robotarium/GTernal/CAD Files/OBJ Files/Top Main Plate.obj

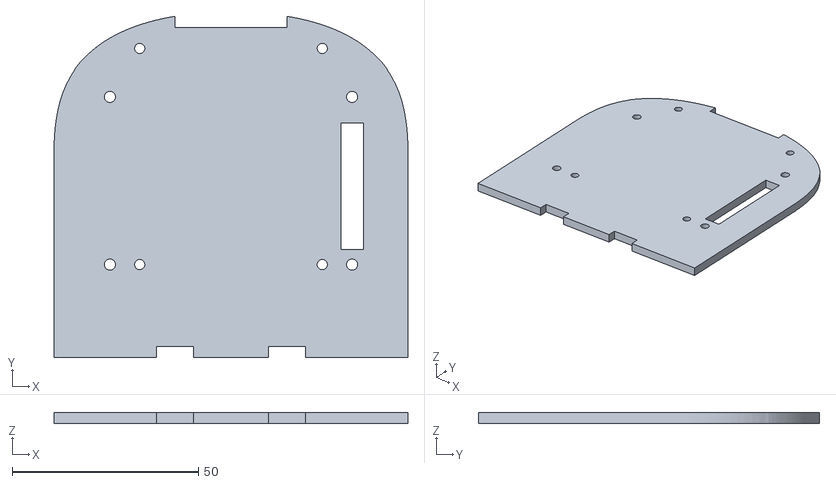
[picture p1: CAD file, 2023-09-16, last stored version]
CAD Files/OBJ Files/Top Main Plate.obj
95.0 x 91.6 x 3.00
