robotarium/GTernal/CAD Files/OBJ Files/Camera Mount V3.obj

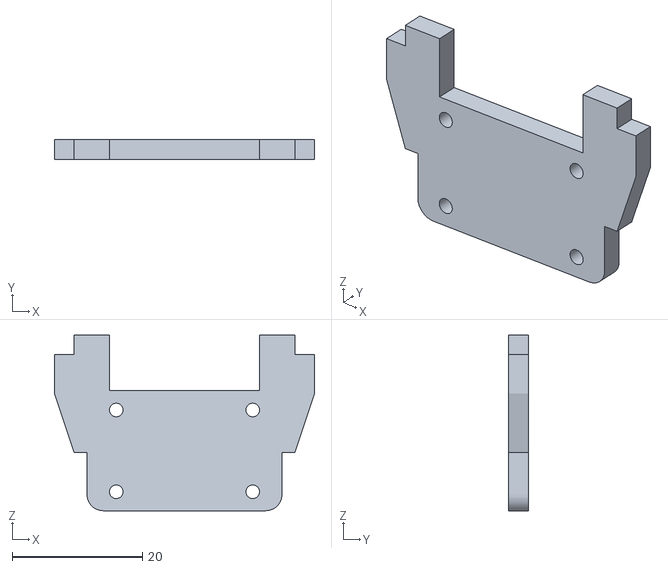
[picture p2: CAD file, 2023-09-16, last stored version]
CAD Files/OBJ Files/Camera Mount V3.obj
40.0 x 3.00 x 27.0
