robotarium/GTernal/CAD Files/OBJ Files/Top Plate V2.obj

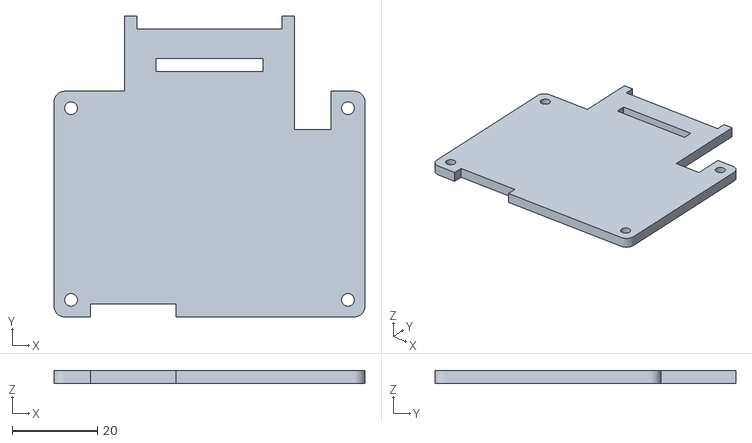
[picture p3: CAD file, 2023-09-16, last stored version]
CAD Files/OBJ Files/Top Plate V2.obj
73.0 x 70.6 x 3.00
