robotarium/GTernal/CAD Files/OBJ Files/Distance Sensor mount sub part 1 V1.obj

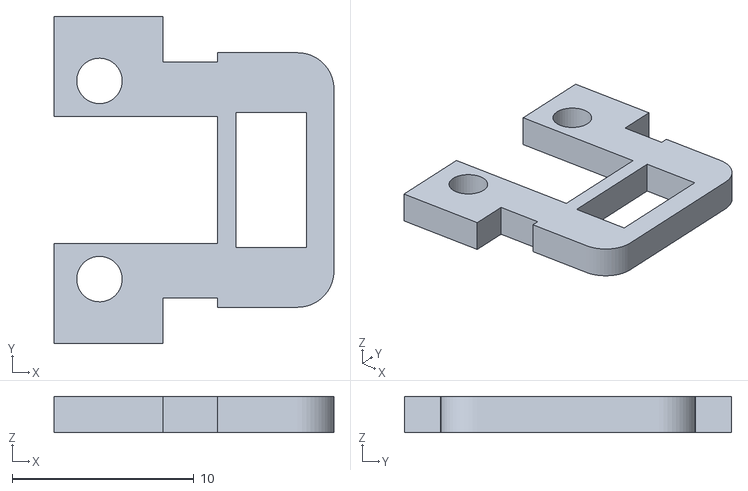
[picture p4: CAD file, 2023-09-16, last stored version]
CAD Files/OBJ Files/Distance Sensor mount sub part 1 V1.obj
15.4 x 18.0 x 2.00
