robotarium/GTernal/CAD Files/OBJ Files/Distance Sensor Mount Subtractive Part 2 V5.obj

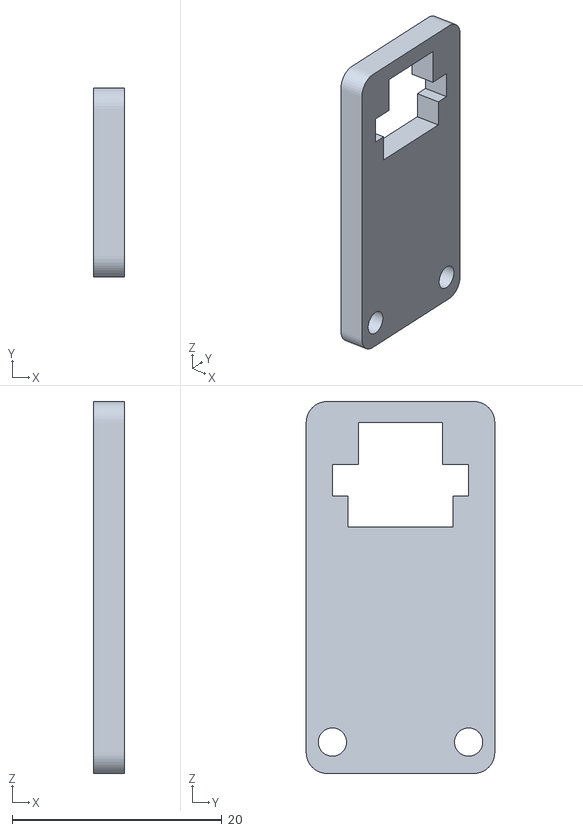
[picture p5: CAD file, 2023-09-16, last stored version]
CAD Files/OBJ Files/Distance Sensor Mount Subtractive Part 2 V5.obj
3.00 x 18.0 x 35.5
