robotarium/GTernal/CAD Files/OBJ Files/Bottom Panel.obj

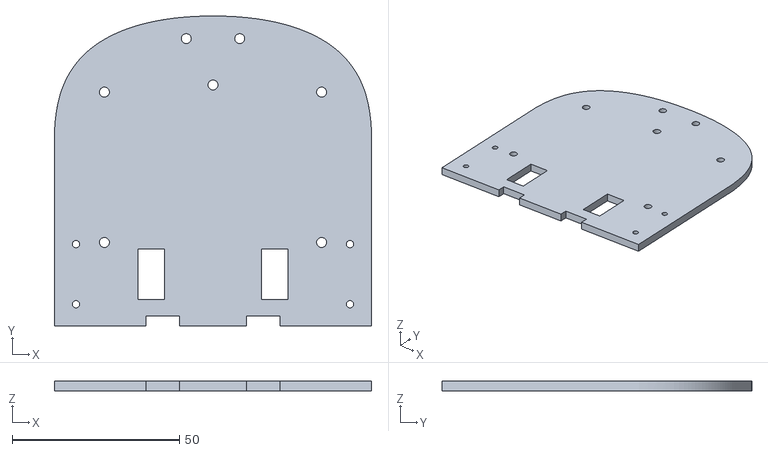
[picture p6: CAD file, 2023-09-16, last stored version]
CAD Files/OBJ Files/Bottom Panel.obj
95.0 x 92.8 x 3.00
