robotarium/GTernal/CAD Files/OBJ Files/Battery Plate.obj

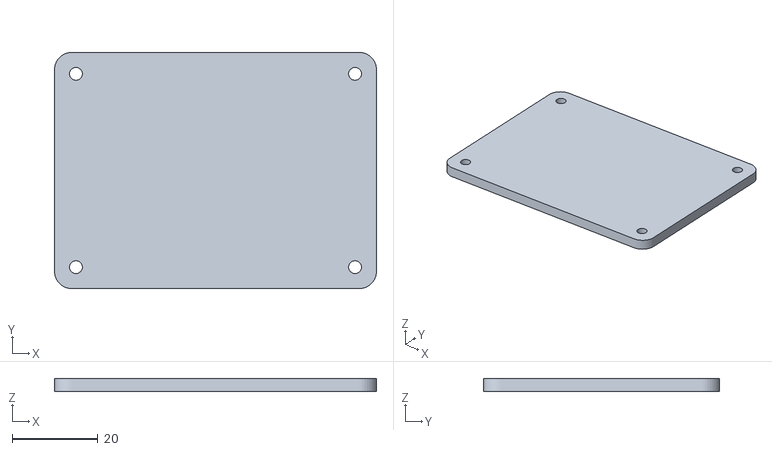
[picture p7: CAD file, 2023-09-16, last stored version]
CAD Files/OBJ Files/Battery Plate.obj
75.0 x 55.0 x 3.00
