robotarium/GTernal/CAD Files/OBJ Files/Back Panel 3mm.obj

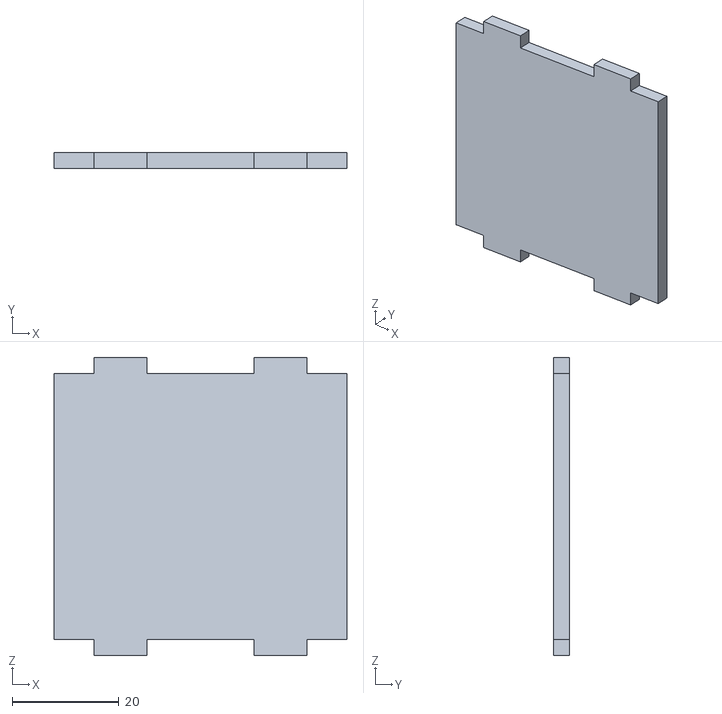
[picture p8: CAD file, 2023-09-16, last stored version]
CAD Files/OBJ Files/Back Panel 3mm.obj
55.0 x 3.00 x 56.0
