robotarium/GTernal/(list of files, cad)

Other CAD files:
CAD Files/Components/EDAC_1743_RJ45_TH.f3d
CAD Files/Components/Pin+Header+2x2+TH+Pitch+2.f3d
CAD Files/Components/SMD+PTC+Fuse+MF-MSMF250_16X.f3d
CAD Files/Components/SOP-3+2.f3d
CAD Files/Components/SOP-3.f3d
CAD Files/Components/TSOP-2+4mm.f3d
CAD Files/Components/TSOP-6+2mm.f3d
CAD Files/Components/TSOP-6+3mm (1).f3d
CAD Files/Components/TSOP-6+3mm.f3d
CAD Files/Components/bcm2837.f3d
CAD Files/Components/cap0402.f3d
CAD Files/Components/cap0603_03.f3d
CAD Files/Components/cap1206.f3d
CAD Files/Components/capar2_1013.f3d
CAD Files/Components/crystal_dfn4.f3d
CAD Files/Components/ind2520.f3d
CAD Files/Components/ledra_0603.f3d
CAD Files/Components/molex+hdmi+smt.f3d
CAD Files/Components/pj-322.f3d
CAD Files/Components/qfn48_9mm.f3d
CAD Files/Components/qfn80_12mm.f3d
CAD Files/Components/qfp16_3x2mm.f3d
CAD Files/Components/resistor_0402.f3d
CAD Files/Components/wlbga140_5mm.f3d
CAD Files/GTernal v29.f3z
CAD Files/GTernal_3.f3z
CAD Files/GTernal_No_PCB v10.f3z
CAD Files/GTernal_No_PCB.f3z
CAD Files/Gritsbot_3.f3z
CAD Files/Gritsbot_No_PCB v10.f3z
CAD Files/Gritsbot_No_PCB.f3z
CAD Files/PCB_Drawing.f3z
CAD Files/PCB_DrawingV2.f3z
CAD Files/RPi_Camera_V2.f3d
CAD Files/ToF Cable Holder Top Mount Subtractive v7.f3z
CAD Files/ToF+Cable+Holder+Top+Mount+Subtractive.f3z
CAD Files/ToF+Cable+Holder+Top+Mount.f3z
CAD Files/VL53L0X+ToF+Sensor.f3d
CAD Files/raspberry_pi_3_b_plus.f3z
PCB Files/mainBoard_GTernal_1-0 v17.f3z
PCB Files/mainBoard_Gritsbot_3-0.f3z
