robotarium/GTernal/PCB Files/mainBoard_Gritsbot_3-0.brd

## EAGLE design PCB Files/mainBoard_Gritsbot_3-0.brd (2023-09-16, last stored version)

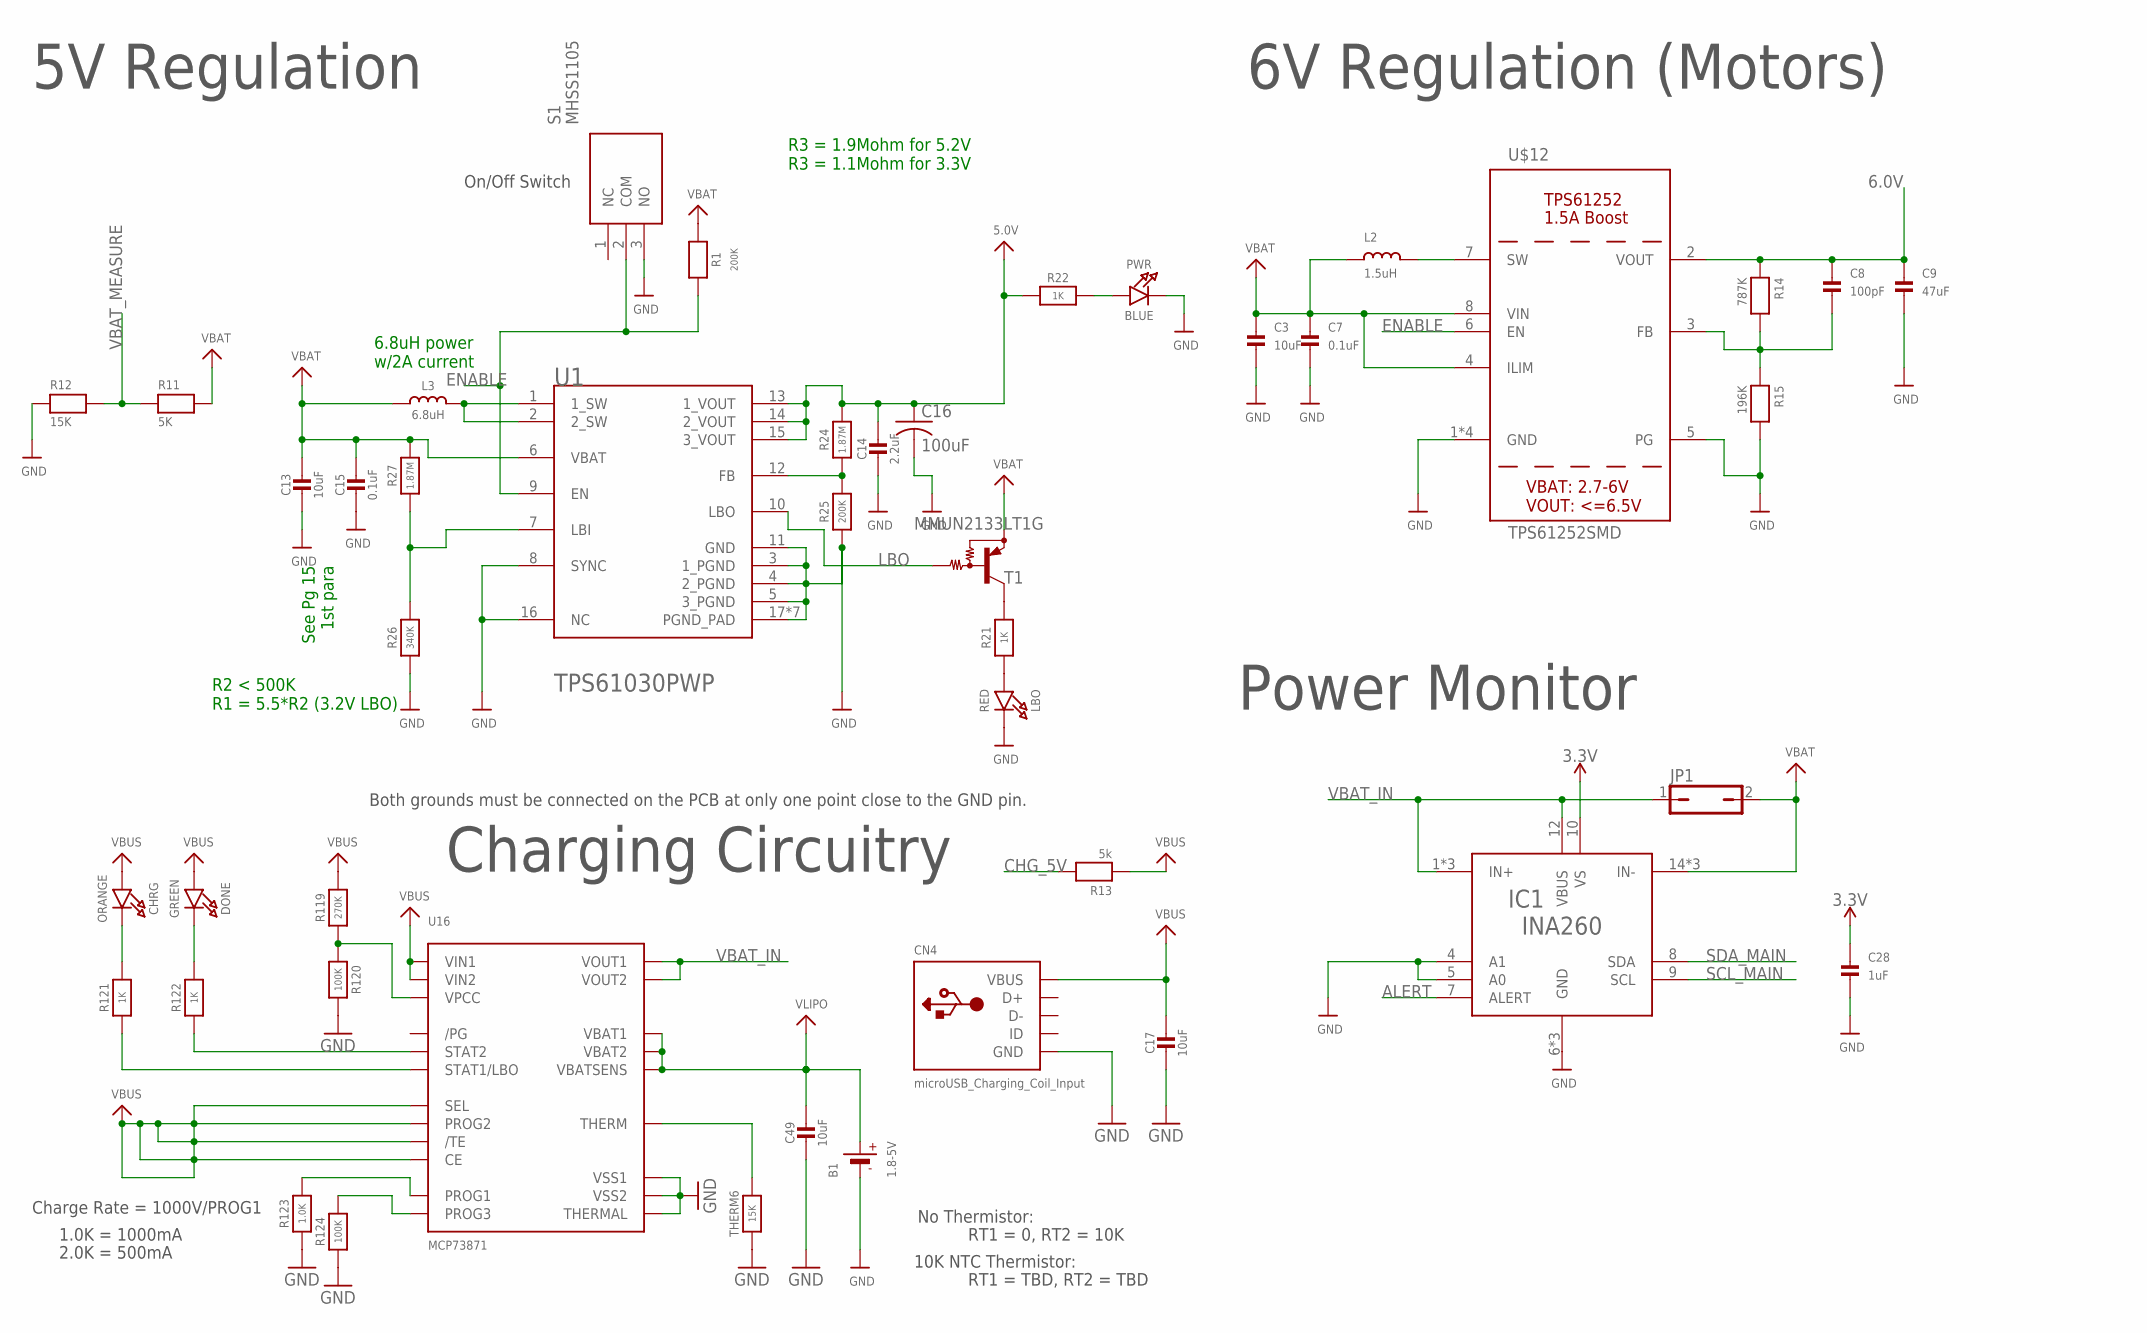
[picture p9: schematic mainBoard_Gritsbot_3-0.sch, sheet 1]

Parts:
B1: 1.8-5V; JSTPH2
C3: 10uF; 0603
C7: 0.1uF; 0805
C8: 100pF; 0603
C9: 47uF; 1206
C13, C17, C49: 10uF; 0805-NO
C14: 2.2uF; 0805-NO
C15: 0.1uF; 0805_10MGAP
C16: 100uF; C1210
C28: 1uF; 0603-NO
CHRG: ORANGE; CHIPLED_0805_NOOUTLINE
CN4: microUSB_Charging_Coil_Input; 4UCONN_20329
DONE: GREEN; CHIPLED_0805_NOOUTLINE
IC1: INA260; TSSOP16
JP1: JP1Q; JP1
L2: 1.5uH; MURATA_DFE252012P-1R5M=P2
L3: 6.8uH; INDUCTOR_5X5MM_TDK_VLC5045
LBO: RED; CHIPLED_0805_NOOUTLINE
PWR: BLUE; CHIPLED_0805_NOOUTLINE
R1, R25: 200K; 0805-NO
R11: 5K; 0805
R12: 15K; 0805
R13: 5k; 0805
R14: 787K; 0805
R15: 196K; 0805
R21, R22, R121, R122: 1K; 0805-NO
R24: 1.87M; 0805-NO
R26: 340K; _0805MP
R27: 1.87M; _0805MP
R119: 270K; 0805-NO
R120, R124: 100K; 0805-NO
R123: 1.0K; 0805-NO
S1: MHSS1105
T1: MMUN2133LT1G; SC59-BEC
THERM6: 15K; 0805-NO
U1: TEXAS_INSTRUMENTS_TPS61030PWPTEXAS_INSTRUMENTS_TP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; TEXAS_INSTRUMENTS_TPS61030PWP_0
U16: MCP73871; QFN20_4MM
U$12: TPS61252SMD; TPS61252

Connections:
3.3V: C28.1, IC1.10 (VS); also elsewhere on the board
5.0V: C14.1, C16.1, R22.1, R24.2, U1.13 (1_VOUT), U1.14 (2_VOUT), U1.15 (3_VOUT); also elsewhere on the board
6.0V: C8.1, C9.1, R14.1, U$12.2 (VOUT); also elsewhere on the board
ALERT: IC1.7 (ALERT)
CHG_5V: R13.2; also elsewhere on the board
ENABLE: R1.2, S1.2 (COM), U1.9 (EN), U$12.6 (EN)
GND: B1.1 (-), C3.2, C7.2, C9.2, C13.2, C14.2, C15.2, C16.2, C17.2, C28.2, C49.2, CN4.BASE@1 (GND), CN4.BASE@2 (GND), CN4.GND, CN4.SPRT@1 (GND), CN4.SPRT@2 (GND), CN4.SPRT@3 (GND), CN4.SPRT@4 (GND), IC1.4 (A1), IC1.5 (A0), IC1.6 (GND), IC1.11 (GND), IC1.13 (GND), LBO.C, PWR.C, R12.1, R15.2, R25.1, R26.1, R120.2, R123.1, R124.1, S1.3 (NO), THERM6.1, U1.3 (1_PGND), U1.4 (2_PGND), U1.5 (3_PGND), U1.8 (SYNC), U1.11 (GND), U1.16 (NC), U1.17 (PGND_PAD), U1.PAD_1 (PGND_PAD), U1.PAD_2 (PGND_PAD), U1.PAD_3 (PGND_PAD), U1.PAD_4 (PGND_PAD), U1.PAD_5 (PGND_PAD), U1.PAD_6 (PGND_PAD), U16.P$10 (VSS1), U16.P$11 (VSS2), U16.P$21 (THERMAL), U$12.1 (GND), U$12.5 (PG), U$12.P$2_GND (GND), U$12.P$3_GND (GND), U$12.THERMAL_GND (GND); also elsewhere on the board
LBO: T1.B, U1.10 (LBO)
unnamed: R24.1, R25.2, U1.12 (FB)
unnamed: L2.P$2 (2), U$12.7 (SW)
unnamed: C8.2, R14.2, R15.1, U$12.3 (FB)
unnamed: L3.P$2 (2), U1.1 (1_SW), U1.2 (2_SW)
unnamed: R26.2, R27.1, U1.7 (LBI)
unnamed: LBO.A, R21.1
unnamed: R21.2, T1.C
unnamed: PWR.A, R22.2
unnamed: R119.1, R120.1, U16.P$2 (VPCC)
unnamed: R122.1, U16.P$7 (STAT2)
unnamed: R121.1, U16.P$8 (STAT1/LBO)
unnamed: R123.2, U16.P$13 (PROG1)
unnamed: THERM6.2, U16.P$5 (THERM)
unnamed: DONE.C, R122.2
unnamed: CHRG.C, R121.2
unnamed: R124.2, U16.P$12 (PROG3)
SCL_MAIN: IC1.9 (SCL); also elsewhere on the board
SDA_MAIN: IC1.8 (SDA); also elsewhere on the board
VBAT: C3.1, C7.1, C13.1, C15.1, IC1.14 (IN-), IC1.15 (IN-), IC1.16 (IN-), JP1.2, L2.P$1 (1), L3.P$1 (1), R1.1, R11.2, R27.2, T1.E, U1.6 (VBAT), U$12.4 (ILIM), U$12.8 (VIN)
VBAT_IN: IC1.1 (IN+), IC1.2 (IN+), IC1.3 (IN+), IC1.12 (VBUS), JP1.1, U16.P$1 (VOUT1), U16.P$20 (VOUT2)
VBAT_MEASURE: R11.1, R12.2; also elsewhere on the board
VBUS: C17.1, CHRG.A, CN4.VBUS, DONE.A, R13.1, R119.2, U16.P$3 (SEL), U16.P$4 (PROG2), U16.P$9 (/TE), U16.P$17 (CE), U16.P$18 (VIN1), U16.P$19 (VIN2)
VLIPO: B1.2 (+), C49.1, U16.P$14 (VBAT1), U16.P$15 (VBAT2), U16.P$16 (VBATSENS)

Notes on the sheet:
R2 < 500K R1 = 5.5*R2 (3.2V LBO)
Charging Circuitry
5V Regulation
6V Regulation (Motors)
Charge Rate = 1000V/PROG1
1.0K = 1000mA
2.0K = 500mA
No Thermistor:
10K NTC Thermistor:
RT1 = 0, RT2 = 10K
RT1 = TBD, RT2 = TBD
Both grounds must be connected on the PCB at only one point close to the GND pin.
On/Off Switch
See Pg 15 1st para
6.8uH power w/2A current
R3 = 1.9Mohm for 5.2V R3 = 1.1Mohm for 3.3V
Power Monitor

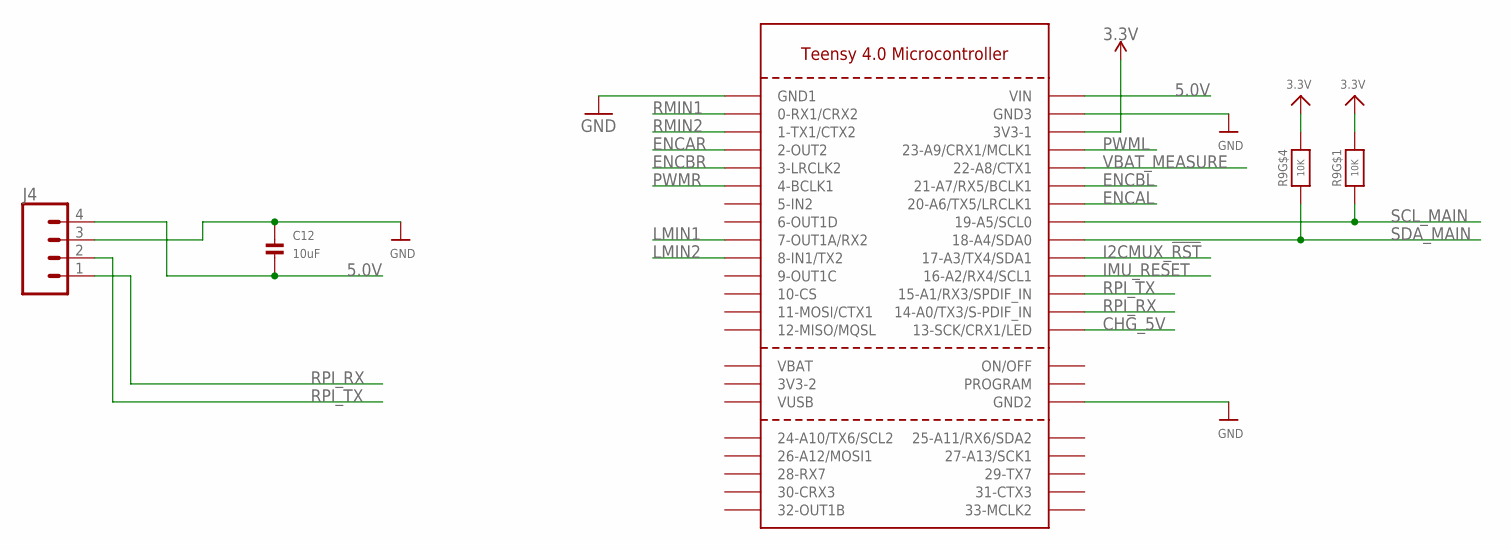
[picture p10: schematic mainBoard_Gritsbot_3-0.sch, sheet 2]

Parts:
C12: 10uF; 0603
J4: CONN_041X04_NO_SILK; 1X04_NO_SILK
R9: 10K; RESPACK_4X0603
U$57: TEENSY40

Connections:
3.3V: R9.1, R9.4 (1), U$57.3V3-1; also elsewhere on the board
5.0V: C12.2, J4.4, U$57.VIN; also elsewhere on the board
CHG_5V: U$57.13-SCK/CRX1/LED; also elsewhere on the board
ENCAL: U$57.20-A6/TX5/LRCLK1; also elsewhere on the board
ENCAR: U$57.2-OUT2; also elsewhere on the board
ENCBL: U$57.21-A7/RX5/BCLK1; also elsewhere on the board
ENCBR: U$57.3-LRCLK2; also elsewhere on the board
GND: C12.1, J4.3, U$57.GND1, U$57.GND2, U$57.GND3; also elsewhere on the board
I2CMUX_!RST: U$57.17-A3/TX4/SDA1; also elsewhere on the board
IMU_RESET: U$57.16-A2/RX4/SCL1; also elsewhere on the board
LMIN1: U$57.7-RX2/OUT1A (7-OUT1A/RX2); also elsewhere on the board
LMIN2: U$57.8-TX2/IN1 (8-IN1/TX2); also elsewhere on the board
PWML: U$57.23-A9/CRX1/CCLK1 (23-A9/CRX1/MCLK1); also elsewhere on the board
PWMR: U$57.4-BCLK2 (4-BCLK1); also elsewhere on the board
RMIN1: U$57.0-RX1 (0-RX1/CRX2); also elsewhere on the board
RMIN2: U$57.1-TX1 (1-TX1/CTX2); also elsewhere on the board
RPI_RX: J4.1, U$57.14-A0/TX3/S-PFI_OUT (14-A0/TX3/S-PDIF_IN)
RPI_TX: J4.2, U$57.15-A1/RX3/S-PDIF_IN (15-A1/RX3/SPDIF_IN)
SCL_MAIN: R9.8 (2), U$57.19-A5/SCL0; also elsewhere on the board
SDA_MAIN: R9.5 (2), U$57.18-A4/SDA0; also elsewhere on the board
VBAT_MEASURE: U$57.22-A8/CTX1; also elsewhere on the board

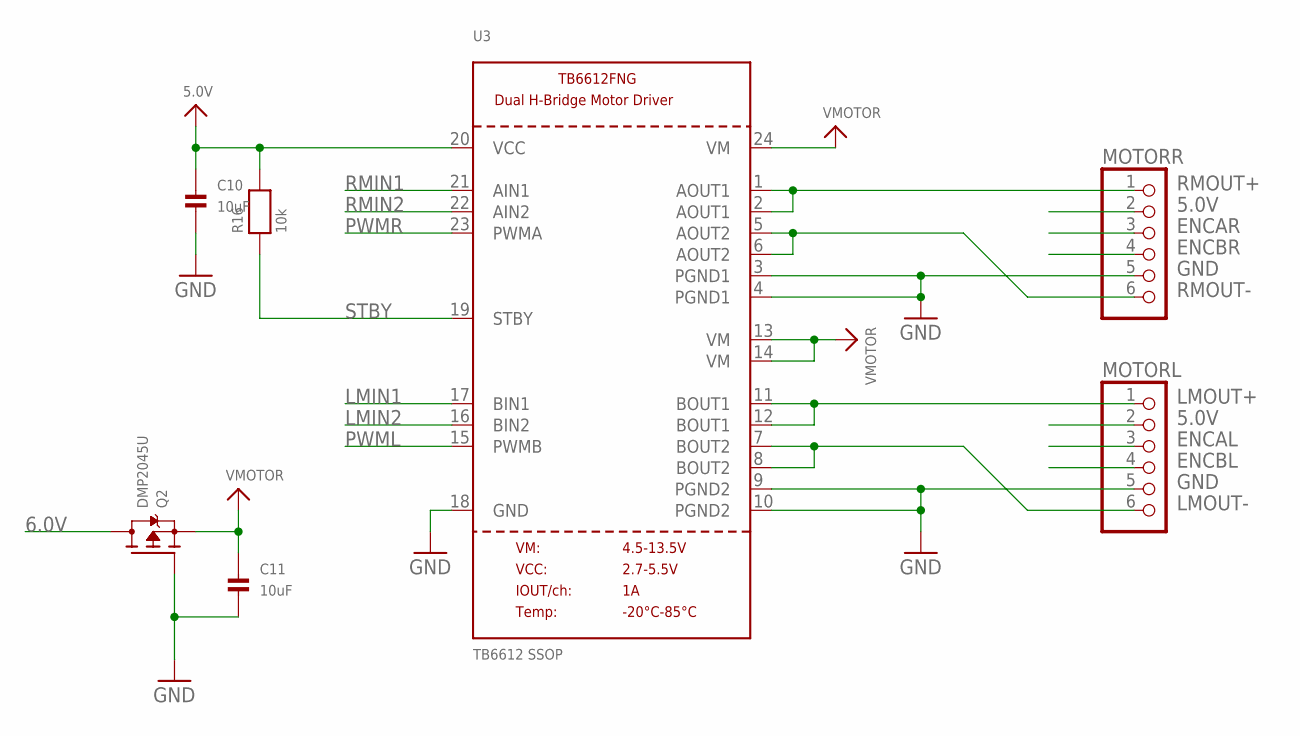
[picture p11: schematic mainBoard_Gritsbot_3-0.sch, sheet 3]

Parts:
C10, C11: 10uF; 0603
MOTORL: PINHD-1X6CB; 1X06-CLEANBIG
MOTORR: PINHD-1X6CB; 1X06-CLEANBIG
Q2: DMP2045U; SOT23-WIDE
R16: 10k; 0805
U3: TB6612 SSOP; SSOP24

Connections:
5.0V: C10.1, MOTORL.2, MOTORR.2, R16.2, U3.20 (VCC); also elsewhere on the board
6.0V: Q2.3 (D); also elsewhere on the board
ENCAL: MOTORL.3; also elsewhere on the board
ENCAR: MOTORR.3; also elsewhere on the board
ENCBL: MOTORL.4; also elsewhere on the board
ENCBR: MOTORR.4; also elsewhere on the board
GND: C10.2, C11.2, MOTORL.5, MOTORR.5, Q2.1 (G), U3.3 (PGND1), U3.4 (PGND1), U3.9 (PGND2), U3.10 (PGND2), U3.18 (GND); also elsewhere on the board
LMIN1: U3.17 (BIN1); also elsewhere on the board
LMIN2: U3.16 (BIN2); also elsewhere on the board
LMOUT+: MOTORL.1, U3.11 (BOUT1), U3.12 (BOUT1)
LMOUT-: MOTORL.6, U3.7 (BOUT2), U3.8 (BOUT2)
PWML: U3.15 (PWMB); also elsewhere on the board
PWMR: U3.23 (PWMA); also elsewhere on the board
RMIN1: U3.21 (AIN1); also elsewhere on the board
RMIN2: U3.22 (AIN2); also elsewhere on the board
RMOUT+: MOTORR.1, U3.1 (AOUT1), U3.2 (AOUT1)
RMOUT-: MOTORR.6, U3.5 (AOUT2), U3.6 (AOUT2)
STBY: R16.1, U3.19 (STBY)
VMOTOR: C11.1, Q2.2 (S), U3.13 (VM), U3.14 (VM), U3.24 (VM)

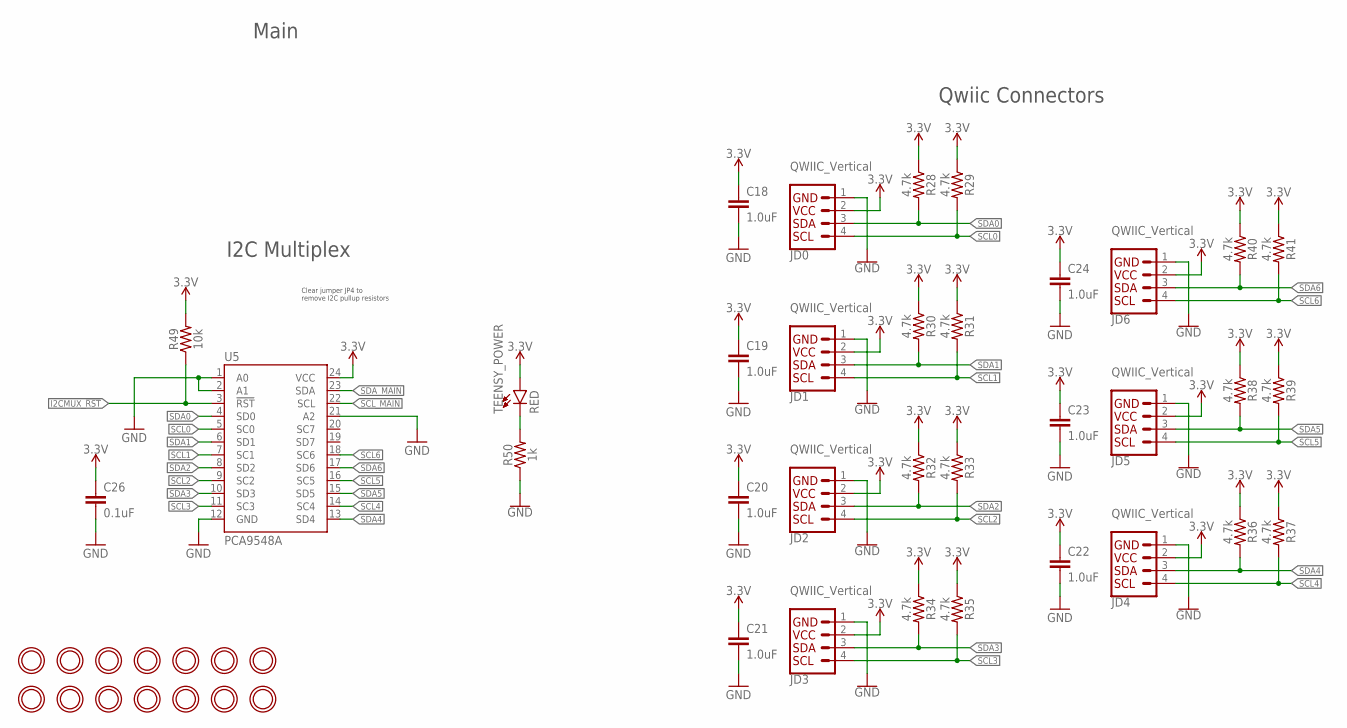
[picture p12: schematic mainBoard_Gritsbot_3-0.sch, sheet 4]

Parts:
C18, C19, C20, C21, C22, C23, C24: 1.0uF; 0603
C26: 0.1uF; 0603
JD0, JD1, JD2, JD3, JD4, JD5, JD6: QWIIC_Vertical; JST04_1MM_VERT
R28, R29, R30, R31, R32, R33, R34, R35, R36, R37, R38, R39, R40, R41: 4.7k; 0603
R49: 10k; 0603
R50: 1k; 0603
TEENSY_POWER: RED; LED-0603
U5: PCA9548A; TSSOP28
U$8, U$30, U$31, U$32, U$33, U$34, U$35, U$36, U$37, U$43, U$45, U$46, U$47, U$48: MOUNTINGHOLE2.5; MOUNTINGHOLE_2.5_PLATED

Connections:
3.3V: C18.1, C19.1, C20.1, C21.1, C22.1, C23.1, C24.1, C26.1, JD0.2, JD1.2, JD2.2, JD3.2, JD4.2, JD5.2, JD6.2, R28.1, R29.1, R30.1, R31.1, R32.1, R33.1, R34.1, R35.1, R36.1, R37.1, R38.1, R39.1, R40.1, R41.1, R49.2, TEENSY_POWER.A, U5.24 (VCC); also elsewhere on the board
GND: C18.2, C19.2, C20.2, C21.2, C22.2, C23.2, C24.2, C26.2, JD0.1, JD1.1, JD2.1, JD3.1, JD4.1, JD5.1, JD6.1, R50.1, U5.1 (A0), U5.2 (A1), U5.12 (GND), U5.21 (A2); also elsewhere on the board
I2CMUX_!RST: R49.1, U5.3 (!RST); also elsewhere on the board
unnamed: R50.2, TEENSY_POWER.C
SCL0: JD0.4, R29.2, U5.5 (SC0)
SCL1: JD1.4, R31.2, U5.7 (SC1)
SCL2: JD2.4, R33.2, U5.9 (SC2)
SCL3: JD3.4, R35.2, U5.11 (SC3)
SCL4: JD4.4, R37.2, U5.14 (SC4)
SCL5: JD5.4, R39.2, U5.16 (SC5)
SCL6: JD6.4, R41.2, U5.18 (SC6)
SCL_MAIN: U5.22 (SCL); also elsewhere on the board
SDA0: JD0.3, R28.2, U5.4 (SD0)
SDA1: JD1.3, R30.2, U5.6 (SD1)
SDA2: JD2.3, R32.2, U5.8 (SD2)
SDA3: JD3.3, R34.2, U5.10 (SD3)
SDA4: JD4.3, R36.2, U5.13 (SD4)
SDA5: JD5.3, R38.2, U5.15 (SD5)
SDA6: JD6.3, R40.2, U5.17 (SD6)
SDA_MAIN: U5.23 (SDA); also elsewhere on the board

Notes on the sheet:
Qwiic Connectors
Main
I2C Multiplex
Clear jumper JP4 to remove I2C pullup resistors

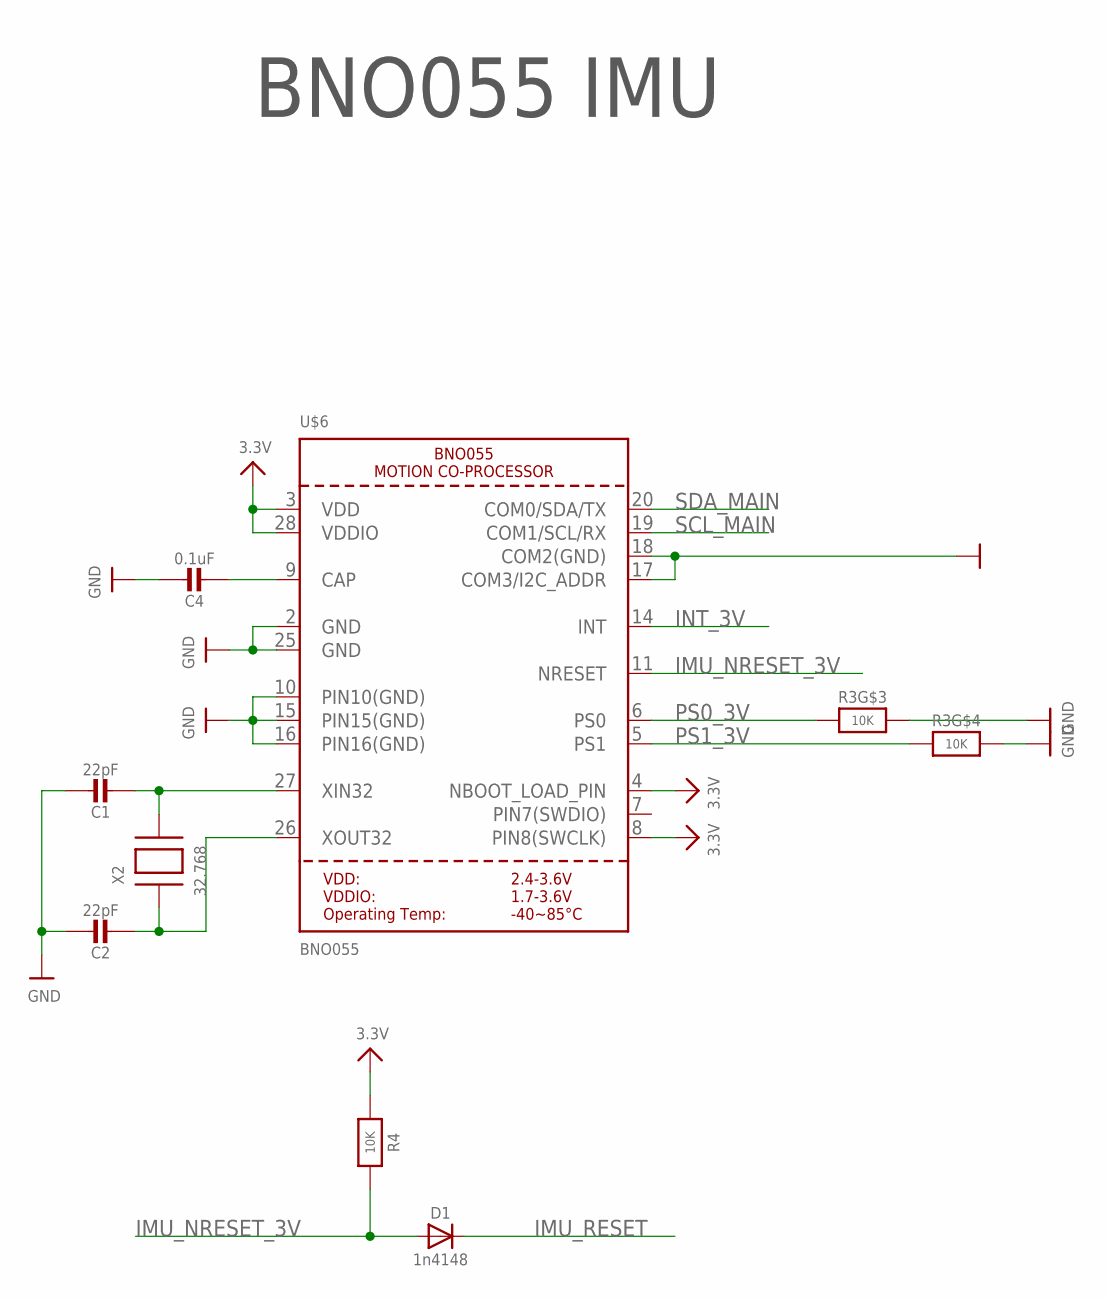
[picture p13: schematic mainBoard_Gritsbot_3-0.sch, sheet 5]

Parts:
C1, C2: 22pF; 0603-NO
C4: 0.1uF; 0603-NO
D1: 1n4148; SOD-323
R3: 10K; RESPACK_4X0603
R4: 10K; 0603-NO
U$6: BNO055
X2: 32.768; XTAL3215

Connections:
3.3V: R4.1, U$6.3 (VDD), U$6.4 (NBOOT_LOAD_PIN), U$6.8 (PIN8(SWCLK)), U$6.28 (VDDIO); also elsewhere on the board
GND: C1.1, C2.1, C4.1, R3.5 (2), R3.6 (2), U$6.2 (GND), U$6.10 (PIN10(GND)), U$6.15 (PIN15(GND)), U$6.16 (PIN16(GND)), U$6.17 (COM3/I2C_ADDR), U$6.18 (COM2(GND)), U$6.25 (GND); also elsewhere on the board
IMU_NRESET_3V: D1.A, R4.2, U$6.11 (NRESET)
IMU_RESET: D1.C; also elsewhere on the board
INT_3V: U$6.14 (INT)
unnamed: C1.2, U$6.27 (XIN32), X2.P$2
unnamed: C2.2, U$6.26 (XOUT32), X2.P$1
unnamed: C4.2, U$6.9 (CAP)
PS0_3V: R3.3 (1), U$6.6 (PS0)
PS1_3V: R3.4 (1), U$6.5 (PS1)
SCL_MAIN: U$6.19 (COM1/SCL/RX); also elsewhere on the board
SDA_MAIN: U$6.20 (COM0/SDA/TX); also elsewhere on the board

Notes on the sheet:
BNO055 IMU

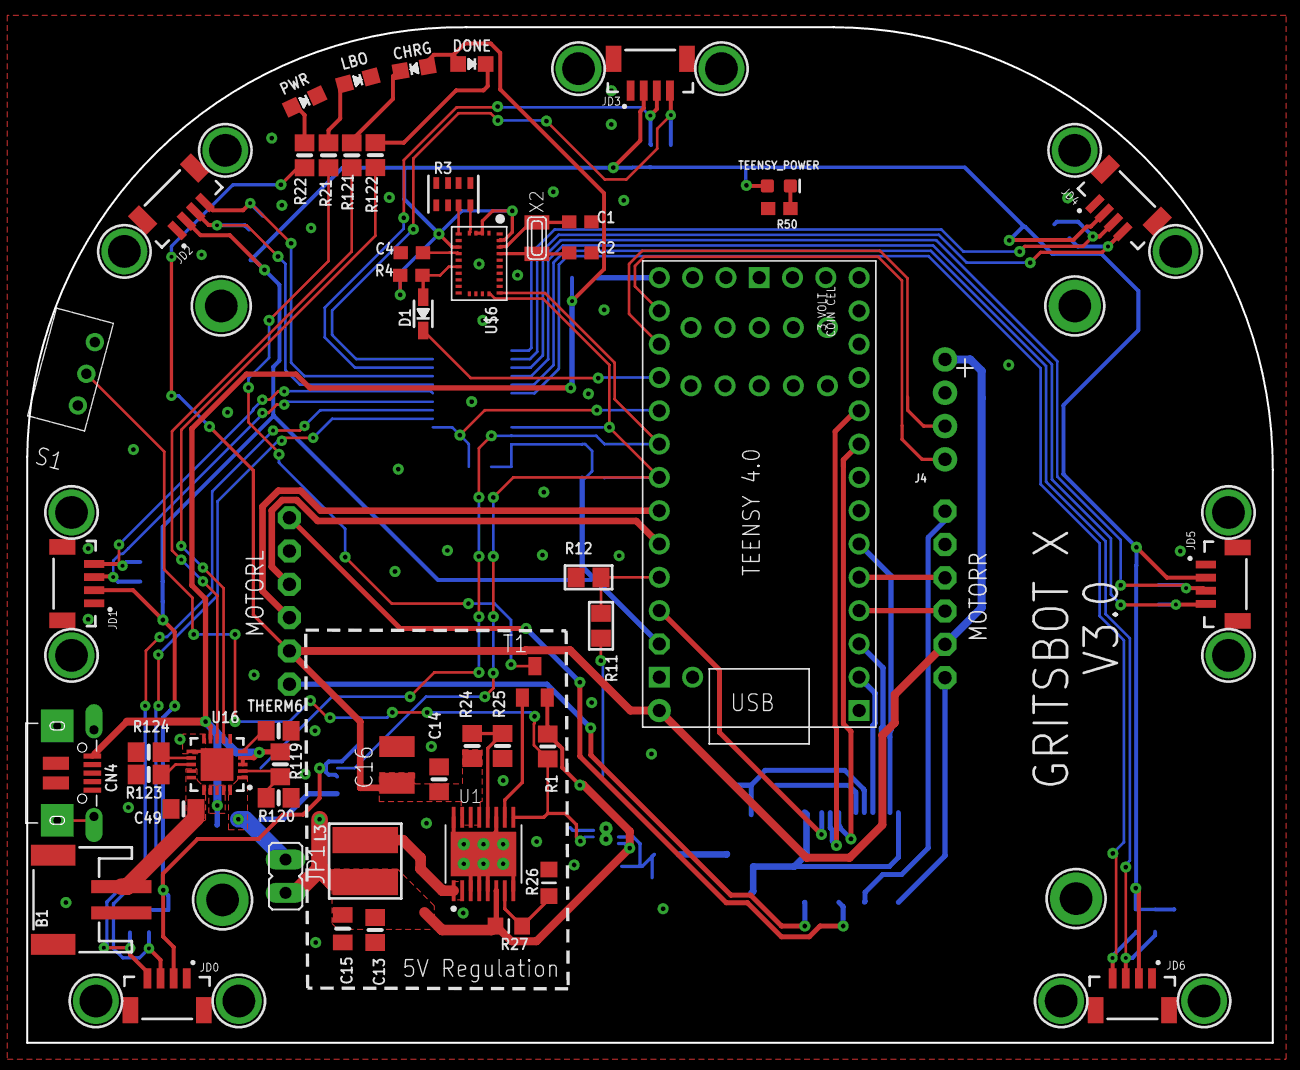
[picture p14: board mainBoard_Gritsbot_3-0.brd from above]

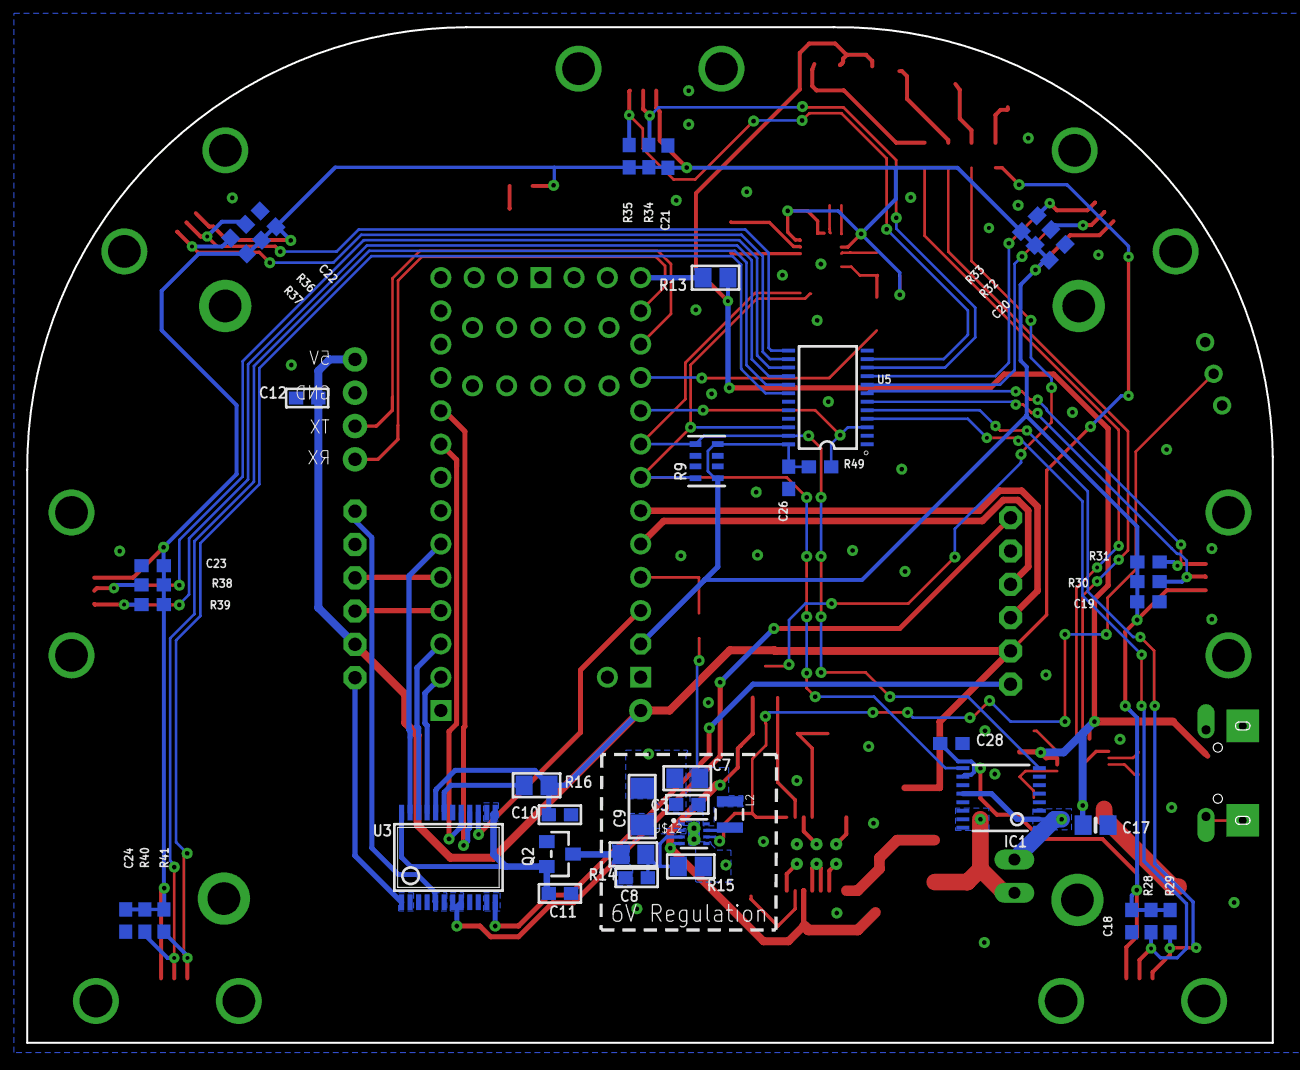
[picture p15: board mainBoard_Gritsbot_3-0.brd from below]

Board: 2 copper layers, 95.0 x 77.5 mm, 115 parts (43 on the bottom side), 71 nets.

Other parts of the board:
U$7, U$23, U$28, U$29: MOUNTINGHOLE_2.5_PLATED_THICK
