robotarium/GTernal/firmware/RPi/pi_firmware.py

import firmware.RPi.gritsbotserial as gritsbotserial
import json
import vizier.node as node
import time
import argparse
import queue
import netifaces
import vizier.log as log
import subprocess

global logger
logger = log.get_logger()

# Constants
MAX_QUEUE_SIZE = 100
LOW_BATT_THRESHOLD = 3900.0 # Low battery threshold voltage in mV
BATT_VOLT_WINDOW = 30 # Time window in seconds for the moving average of the battery voltage. Currently, it is set to 1 sample per second.

def get_mac():
    """Gets the MAC address for the robot from the network config info.
    Returns:
        str: A MAC address for the robot.
    Example:
        >>> print(get_mac())
        AA:BB:CC:DD:EE:FF
    """

    interface = [x for x in netifaces.interfaces() if 'wlan' in x][0]
    return netifaces.ifaddresses(interface)[netifaces.AF_LINK][0]['addr']


def create_node_descriptor(end_point):
    """Returns a node descriptor for the robot based on the end_point.
    The server_alive link is for the robot to check the MQTT connection periodically.
    Args:
        end_point (str): The ID of the robot.
    Returns:
        dict: A node descriptor of the vizier format for the robot.
    Example:
        >>> node_descriptor(1)
    """
    node_descriptor = \
        {
            'end_point': end_point,
            'links':
            {
                '/status': {'type': 'DATA'},
            },
            'requests':
            [
                {
                    'link': 'matlab_api/'+end_point,
                    'type': 'STREAM',
                    'required': False
                },
            ]
        }

    return node_descriptor

# Responses
# Battery voltage response
# response = {'status': 1, 'body': {'bat_volt': 4.3}}


class Request:
    """Represents serial requests to the microcontroller.
    The serial communications operate on a request/response architecture.  For example, the request is of a form (when JSON encoded)
    .. code-block:: python
        {'request': ['read', 'write', 'read'], 'iface': [iface1, iface2, iface3], body: [body1, body2, body3]}
    Attributes:
        request (list): A list of requests (or actions) to perform.  Must be 'read' or 'write'.
        iface (list): A list of interfaces on which to perform the request
        body (list): A list of bodies for the requests.  These are empty if the request is a read.
    """

    def __init__(self):
        """Initializes a request with optional iface, request, and body parameters.
        Returns:
            The created request.
        """
        self.iface = []
        self.request = []
        self.body = []

    def add_write_request(self, iface, body):
        """Adds a write to the request.
        Args:
            iface (str): The interface to write.
            body (dict): A JSON-encodable body to be written.
        Returns:
            The modified request containing the new interface and body.
        Examples:
            >>> r = Request().add_write_request('motor', {'v': 0.1, 'w': 0.0})
        """

        self.iface.append(iface)
        self.request.append('write')
        self.body.append(body)

        return self

    def add_read_request(self, iface):
        """Adds a read to the request.
        Args:
            iface (str): Interface from which to read.
        Returns:
            The request with the added read.
        """

        self.iface.append(iface)
        self.request.append('read')
        self.body.append({})

        return self

    def to_json_encodable(self):
        """Turns the request into a JSON-encodable dict.
        Raises:
            Exception: If an underlying body element is not JSON-encodable.
        Returns:
            dict: A JSON-encodable dict representing the request.
        """

        req = {'request': self.request, 'iface': self.iface}

        if(self.body):
            req['body'] = self.body

        return req


def handle_write_response(status, body):
    return {}


def handle_read_response(iface, status, body):

    if(iface in body):
        return {iface: body[iface]}
    else:
        logger.critical('Request for ({0}) not in body ({1}) after request.'.format(iface, body))
        return {}

def avgVoltage(battVoltArray, voltNew, battVoltIndx, chargeStatusArray, statusNew):
    battVoltArray[battVoltIndx] = voltNew
    avgVolt = sum(battVoltArray)/len(battVoltArray)
    chargeStatusArray[battVoltIndx] = statusNew

    battVoltIndx = battVoltIndx + 1
    if battVoltIndx >= BATT_VOLT_WINDOW:
        battVoltIndx = 0

    return avgVolt, battVoltIndx


def main():

    parser = argparse.ArgumentParser()
    parser.add_argument("mac_list", help="JSON file containing MAC to id mapping")
    parser.add_argument("-port", type=int, help="MQTT Port", default=8080)
    parser.add_argument("-host", help="MQTT Host IP", default="localhost")
    parser.add_argument('-update_rate', type=float, help='Update rate for robot main loop', default=0.016)
    parser.add_argument('-status_update_rate', type=float, help='How often to check status info', default=1)

    # Retrieve the MAC address for the robot
    mac_address = get_mac()

    # Parser and set CLI arguments
    args = parser.parse_args()
    update_rate = args.update_rate
    status_update_rate = args.status_update_rate

    # Retrieve the MAC list file, containing a mapping from MAC address to robot ID
    try:
        f = open(args.mac_list, 'r')
        mac_list = json.load(f)
    except Exception as e:
        print(repr(e))
        print('Could not open file ({})'.format(args.node_descriptor))

    if(mac_address in mac_list):
        robot_id = mac_list[mac_address]
    else:
        print('MAC address {} not in supplied MAC list file'.format(mac_address))
        raise ValueError()

    logger.info('This is robot: ({0}) with MAC address: ({1})'.format(robot_id, mac_address))

    # Create node descriptor for robot and set up links
    node_descriptor = create_node_descriptor(mac_list[mac_address])
    status_link = robot_id + '/status'
    input_link = 'matlab_api/' + robot_id

    started = False
    robot_node = None
    while (not started):
        robot_node = node.Node(args.host, args.port, node_descriptor)
        try:
            robot_node.start()
            started = True
        except Exception as e:
            logger.critical('Could not start robot node.')
            logger.critical(repr(e))
            robot_node.stop()

        # Don't try to make nodes too quickly
        time.sleep(1)

    logger.info('Started robot node.')

    started = False
    serial = None
    while (not started):
        serial = gritsbotserial.GritsbotSerial(serial_dev='/dev/ttyAMA0', baud_rate=500000)
        try:
            serial.start()
            started = True
        except Exception as e:
            # This class stops itself if the device cannot be initially acquired, so we don't need to stop it.
            logger.critical('Could not acquire serial device.')
            logger.critical(repr(e))

        # Don't try to acquire the serial device too quickly
        time.sleep(1)

    logger.info('Acquired serial device.')

    # Queues for STREAM links
    inputs = robot_node.subscribe(input_link)

    # Initialize times for various activities
    start_time = time.time()
    print_time = time.time()
    status_update_time = time.time()

    # Fast charging
    battVoltArray = [0]*BATT_VOLT_WINDOW
    battVoltIndx = 0
    battThreshold = LOW_BATT_THRESHOLD
    chargeStatusArray = [0]*BATT_VOLT_WINDOW

    # Initialize data
    status_data = {'batt_volt': -1, 'charge_status': False, 'bus_volt':-1, 'bus_current':-1, 'power':-1}
    last_input_msg = {}

    # Main loop for the robot
    serial._serial.reset_input_buffer()
    serial._serial.reset_output_buffer()
    while True:
        start_time = time.time()

        # Serial requests
        request = Request()
        handlers = []

        # Retrieve status data: battery voltage and charging status
        if((start_time - status_update_time) >= status_update_rate):
            request.add_read_request('batt_volt').add_read_request('charge_status')
            request.add_read_request('bus_volt').add_read_request('bus_current').add_read_request('power')
            handlers.append(lambda status, body: handle_read_response('batt_volt', status, body))
            handlers.append(lambda status, body: handle_read_response('charge_status', status, body))
            handlers.append(lambda status, body: handle_read_response('bus_volt', status, body))
            handlers.append(lambda status, body: handle_read_response('bus_current', status, body))
            handlers.append(lambda status, body: handle_read_response('power', status, body))

            if status_data['bus_volt'] > 0:
                avgVolt, battVoltIndx = avgVoltage(battVoltArray, status_data['bus_volt'], battVoltIndx, chargeStatusArray, status_data['charge_status'])
                logger.info('avgVolt = ({})'.format(avgVolt))

            status_update_time = start_time

        # Process input commands
        input_msg = None
        # Make sure that the queue has few enough messages
        if(inputs.qsize() > MAX_QUEUE_SIZE):
            logger.critical('Queue of motor messages is too large.')

        try:
            # Clear out the queue
            while True:
                input_msg = inputs.get_nowait()
        except queue.Empty:
            pass

        if(input_msg is not None):
            try:
                input_msg = json.loads(input_msg.decode(encoding='UTF-8'))
            except Exception as e:
                logger.warning('Got malformed JSON motor message ({})'.format(input_msg))
                logger.warning(e)
                # Set this to None for the next checks
                input_msg = None

        # If we got a valid JSON input msg, look for appropriate commands
        if(input_msg is not None):
            last_input_msg = input_msg
            if('v' in input_msg and 'w' in input_msg):
                # Handle response?
                request.add_write_request('motor', {'v': input_msg['v'], 'w': input_msg['w']})
                handlers.append(handle_write_response)

            if('left_led' in input_msg):
                request.add_write_request('left_led', {'rgb': input_msg['left_led']})
                handlers.append(handle_write_response)

            if('right_led' in input_msg):
                request.add_write_request('right_led', {'rgb': input_msg['right_led']})
                handlers.append(handle_write_response)

        # Write to serial port
        response = None
        if(len(handlers) > 0 and serial._serial.is_open):
            try:
                response = serial.serial_request(request.to_json_encodable())
            except Exception as e:
                logger.critical('Serial exception.')
                logger.critical(e)

        # Call handlers
        # We'll have a status and body for each request
        if(response is not None and 'status' in response and 'body' in response
           and len(response['status']) == len(handlers) and len(response['body']) == len(handlers)):
            status = response['status']
            body = response['body']
            # Ensure the appropriate handler gets each response
            for i, handler in enumerate(handlers):
                status_data.update(handler(status[i], body[i]))
            logger.info('Status data ({})'.format(status_data))
            logger.info('Response ({})'.format(response))
            # logger.info('Battery Voltage ({})'.format(status_data['bus_volt']))
            # logger.info('Length of handlers ({})'.format(len(handlers))) # For debugging
        else:
            # If we should have responses, but we don't
            if(len(handlers) > 0):
                logger.critical('Malformed response ({})'.format(response))
                logger.info('Length of handlers ({})'.format(len(handlers)))

        robot_node.put(status_link, json.dumps(status_data))

        # If the average battery voltage is below the threshold, and the robot is being charged, enter fast charging mode
        if not 0 in battVoltArray and avgVolt < battThreshold and not 0 in chargeStatusArray:
            logger.info('Charging battery voltage for 30 seconds: ({0}) mV < ({1}) mV. Entering fast charging mode'.format(round(avgVolt, 2), battThreshold))

            # Signal Teensy that Raspberry Pi is entering fast charging mode
            request = Request()
            request.add_write_request('fast_charge', {})
            handlers.append(handle_write_response)
            response = None
            if(len(handlers) > 0 and serial._serial.is_open):
                try:
                    response = serial.serial_request(request.to_json_encodable())
                except Exception as e:
                    logger.critical('Serial exception.')
                    logger.critical(e)

            # Shut down the Raspberry Pi through ssh from the firmware Docker image
            cmd = ['sshpass', '-p', 'raspberry', 'ssh', '-o', 'UserKnownHostsFile=/dev/null', '-o', 'StrictHostKeyChecking=no', 'pi@localhost', 'sudo shutdown now']
            pid = subprocess.Popen(cmd, stdout=subprocess.PIPE)
            pid.communicate()

        # # Print out status data
        # if((start_time - print_time) >= status_update_rate):
        #     logger.info('Status data ({})'.format(status_data))
        #     logger.info('Last input message received ({})'.format(last_input_msg))
        #     print_time = time.time()

        # Sleep for whatever time is left at the end of the loop
        time.sleep(max(0, update_rate - (time.time() - start_time)))


if __name__ == '__main__':
    main()
