robotarium/GTernal/(commit log)

2023-09-16 Initial uploads
    [BOM Gritsbot 3.0.xlsx, Back Panel 3mm.obj, Battery Plate.obj, Bottom Panel.obj, Camera Mount V3.obj, Distance Sensor Mount Subtractive Part 2 V5.obj, Distance Sensor mount sub part 1 V1.obj, EDAC_1743_RJ45_TH.f3d]
2023-09-24 Code clean-ups
    [GTernal_3.f3z, GTernal_No_PCB v10.f3z, GTernal_No_PCB.f3z]
2023-09-28 Moved design files to a separate repository. The GTernal_design_diles is a submodule of this repository.
    [Back Panel 3mm.obj, Battery Plate.obj, Bottom Panel.obj, Camera Mount V3.obj, Distance Sensor Mount Subtractive Part 2 V5.obj, Distance Sensor mount sub part 1 V1.obj, EDAC_1743_RJ45_TH.f3d, GTernal v29.f3z]
2023-10-18 Updated README.md with Raspberry Pi OS version compatibility message
2023-10-18 Updated readme with Raspberry Pi OS version compatibility message
2024-04-30 Added local installation scripts and fast charging mode for the main branch
2025-03-07 Merged Teensy firmware codes from the test branch
2025-03-07 Set the design file submodule to track main
2025-03-12 Teensy firmware code clean-up
2025-03-13 Starting IP addresses for network device discovery can be configured in env_variables.sh
2025-03-13 Added automatic network device discovery script. Updated restart_docker_containers.sh to use sshpass
